mmimadi/dancelight/Marketing/photo_2020-08-12_01-08-17.jpg

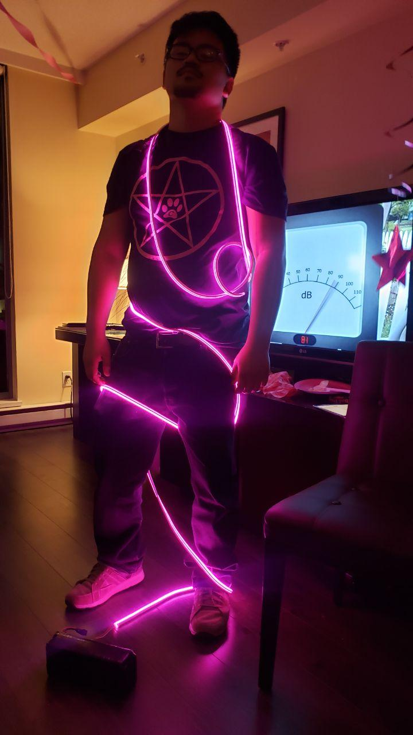
Marketing/photo_2020-08-12_01-08-17.jpg
