mmimadi/dancelight/Marketing/Depositphotos_21451605_s-2015.jpg

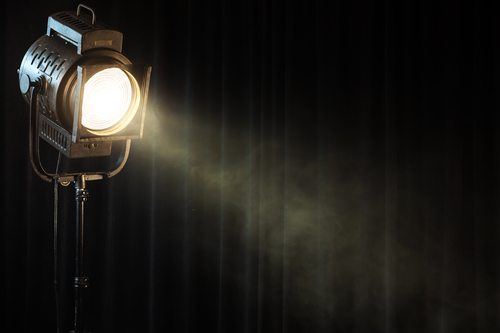
Marketing/Depositphotos_21451605_s-2015.jpg
