mmimadi/dancelight/Bom.xlsx

BOM
Rave Light Driver PCB Main Board | Yellow = No Assembly
Rev 1
Reference | Value/Part Number | Footprint | MPN | LCSC Part # | Notes | Datasheet | Source
C1, C2, C3 | 10uf | Capacitor_SMD:CP_Elec_4x5.3 | VE-100M1ETR-0405 | C134721 (https://lcsc.com/product-detail/Aluminum-Electrolytic-Capacitors-SMD_Lelon-VE-100M1ETR-0405_C134721.html/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) |  | ~
C4, C12 | 22uf | Capacitor_SMD:C_0603_1608Metric | CL21A226MAQNNNE | C45783 (https://lcsc.com/product-detail/Multilayer-Ceramic-Capacitors-MLCC-SMD-SMT_SAMSUNG_CL21A226MAQNNNE_22uF-226-20-25V_C45783.html/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) |  | ~
C5, C6 | 100uf | Capacitor_SMD:CP_Elec_6.3x7.7 | VES101M1ETR-0607 | C176675 (https://lcsc.com/product-detail/Aluminum-Electrolytic-Capacitors-SMD_Lelon-VES101M1ETR-0607_C176675.html/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) |  | ~
C8, C9 | 1uf | Capacitor_SMD:C_0603_1608Metric | CL10A105KB8NNNC | C15849 (https://lcsc.com/product-detail/Multilayer-Ceramic-Capacitors-MLCC-SMD-SMT_SAMSUNG_CL10A105KB8NNNC_1uF-105-10-50V_C15849.html/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) |  | ~
C10 | 10uf | Capacitor_SMD:C_0603_1608Metric | CL10A106KP8NNNC | C19702 (https://lcsc.com/product-detail/Multilayer-Ceramic-Capacitors-MLCC-SMD-SMT_SAMSUNG_CL10A106KP8NNNC_10uF-106-10-10V_C19702.html/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) |  | ~
C7, C11 | .1uf | Capacitor_SMD:C_0603_1608Metric | CC0603KRX7R9BB104 | C14663 (https://lcsc.com/product-detail/Multilayer-Ceramic-Capacitors-MLCC-SMD-SMT_100nF-104-10-50V_C14663.html/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) |  | ~
D1, D2, D3 | 1N5819 | Diode_SMD:D_SOD-323 | 1N5819WS | C191023 (https://lcsc.com/product-detail/Others_B5819WS_C191023.html/?href=jlc-SMT) |  | ~
FB1 | 2A Ferrite Bead | Resistor_SMD:R_0805_2012Metric | PZ2012U221-2R0TF | C44361 (https://lcsc.com/product-detail/Beads_Sunlord-PZ2012U221-2R0TF_C44361.html/?href=jlc-SMT) |  | ~
L1 | 10uh | Inductor_SMD:L_Sunlord_MWSA0518_5.4x5.2mm | MWSA0503-100MT | C139506 (https://lcsc.com/product-detail/Power-Inductors_Sunlord-MWSA0503-100MT_C139506.html/?href=jlc-SMT) |  | ~
L2 | 1uh | Inductor_SMD:L_0805_2012Metric | MLP2016S1R0MT0S1 | C76793 (https://lcsc.com/product-detail/Inductors-SMD_TDK_MLP2016S1R0MT0S1_TDK-MLP2016S1R0MT0S1_C76793.html/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) |  | ~
Q1, Q2 | MMBT3904-TP | Package_TO_SOT_SMD:SOT-23 | MMBT3904-TP | C77991 (https://lcsc.com/product-detail/Transistors_MCC_MMBT3904-TP_MMBT3904-TP_C77991.html/?href=jlc-SMT) |  | ~
Q3 | AO4484 | Main Board1:SOIC-8_3.9x4.9mm_P1.27mm | AO4484 |  |  | http://www.ti.com/lit/gpn/csd16342q5a
R1 | 6.8k | Resistor_SMD:R_0603_1608Metric | 0603WAF6801T5E | C23212 (https://lcsc.com/product-detail/Chip-Resistor-Surface-Mount_Uniroyal-Elec-0603WAF6801T5E_C23212.html/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) |  | ~
R2, R5 | 100k | Resistor_SMD:R_0603_1608Metric | 0603WAF1003T5E | C25803 (https://lcsc.com/product-detail/Chip-Resistor-Surface-Mount_Uniroyal-Elec-0603WAF1003T5E_C25803.html/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) |  | ~
R3, R6, R14, R18, R19 | 10k | Resistor_SMD:R_0603_1608Metric | 0603WAF1002T5E | C25804 (https://lcsc.com/product-detail/Chip-Resistor-Surface-Mount_Uniroyal-Elec-0603WAF1002T5E_C25804.html/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) |  | ~
R4, R7, R9 | 1k | Resistor_SMD:R_0603_1608Metric | 0603WAF1001T5E | C21190 (https://lcsc.com/product-detail/Chip-Resistor-Surface-Mount_Uniroyal-Elec-0603WAF1001T5E_C21190.html/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) |  | ~
R12 | 205k | Resistor_SMD:R_0603_1608Metric | 0603WAF2053T5E | C22949 (https://lcsc.com/product-detail/Chip-Resistor-Surface-Mount_Uniroyal-Elec-0603WAF2053T5E_C22949.html/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) |  | ~
R13 | 68k | Resistor_SMD:R_0603_1608Metric | 0603WAF6802T5E | C23231 (https://lcsc.com/product-detail/Chip-Resistor-Surface-Mount_Uniroyal-Elec-0603WAF6802T5E_C23231.html/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) |  | ~
R15 | 43k | Resistor_SMD:R_0603_1608Metric | 0603WAF4302T5E | C23172 (https://lcsc.com/product-detail/Chip-Resistor-Surface-Mount_Uniroyal-Elec-0603WAF4302T5E_C23172.html/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) |  | ~
R16 | 2.7k | Resistor_SMD:R_0603_1608Metric | 0603WAF2701T5E | C13167 (https://lcsc.com/product-detail/Chip-Resistor-Surface-Mount_Uniroyal-Elec-0603WAF2701T5E_C13167.html/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) |  | ~
R8, R17 | 1M | Resistor_SMD:R_0603_1608Metric | 0603WAF1004T5E | C22935 (https://lcsc.com/product-detail/Chip-Resistor-Surface-Mount_Uniroyal-Elec-0603WAF1004T5E_C22935.html/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) |  | ~
R20 | 220R | Resistor_SMD:R_0603_1608Metric | 0603WAF2200T5E | C22962 (https://lcsc.com/product-detail/Chip-Resistor-Surface-Mount_Uniroyal-Elec-0603WAF2200T5E_C22962.html/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) |  | ~
SW1 | Momentary | Main Board1:tactile | TS-1187A-C-E-B | C318887 (https://lcsc.com/product-detail/Tactile-Switches_XKB-Enterprise-TS-1187A-C-E-A_C318887.html/?href=jlc-SMT) |  | ~
TH1 | Thermistor | Capacitor_SMD:C_0805_2012Metric | NTCG163JF103FT1 | C76589 (https://lcsc.com/product-detail/NTC-Thermistors_TDK_NTCG163JF103FT1_NTC-Thermistor-10KR-1_C76589.html/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) |  | ~
U1 | MT3608 Boost Converter | SOT-23-6 | MT3608 | C84817 (https://lcsc.com/product-detail/DC-DC-Converters_MT3608_C84817.html/?href=jlc-SMT) |  | https://datasheet.lcsc.com/szlcsc/XI-AN-Aerosemi-Tech-MT3608_C84817.pdf
U2 | NCP718A Linear Reg | 6-WDFN | NCP718AMTADJTBG |  |  | https://www.onsemi.com/pub/Collateral/NCP718-D.PDF
U3 | ATTINY 1614 | SOIC-14 | ATTINY1614-SSFR | C141724 (https://lcsc.com/product-detail/ATMEL-AVR_Microchip-Tech_ATTINY1614-SSFR_Microchip-Tech-ATTINY1614-SSFR_C141724.html/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) |  | https://datasheet.lcsc.com/szlcsc/Microchip-Tech-ATTINY1614-SSFR_C141724.pdf
