mmimadi/dancelight/Expenses.xlsx

Item | Quantity | Price | From | Notes
Condensor Mic | 4 | $4.50 | digikey
10uf electroyltic caps | 5 | $2 | digikey
NPN BJT transistor | 10 | $5 | digikey
Lights, Fets, cables and chargers | lots! | $20 | ali express | I don’t remember lol
digikey prototype order | lots! | $50 | digikey | I don’t remember lol
Production test run LED order | for 12x units | $70 | ali express | split half
boost test boards | 2 units | $5.50 | amazon | I fucked these up. Just scrap this cost lol
Prouction Run | 30 units SMT | $172 | JLCPCB | already split half
DIGI parts for first run | lots! | $84
 | Sum: | $413.00
