mmimadi/dancelight/3D Models/Case/Rave Light Case.SLDPRT

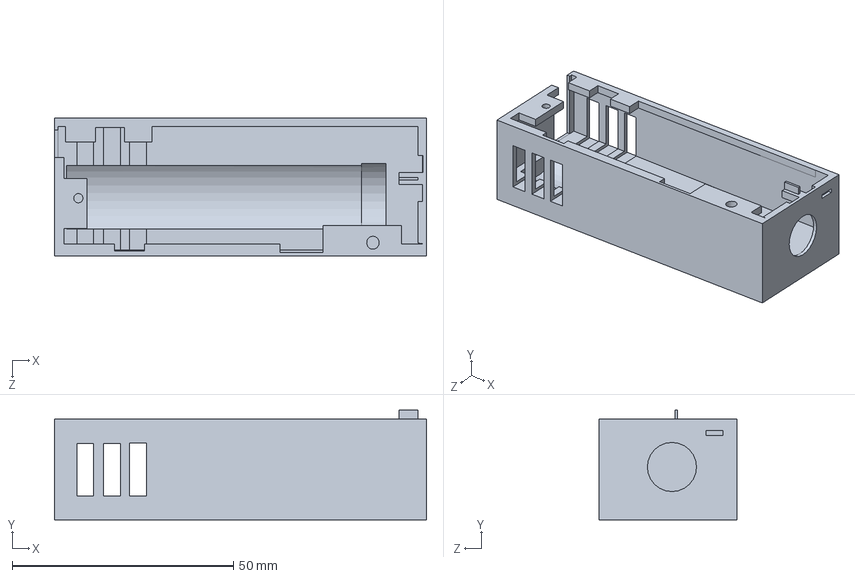
[picture p3: CAD file, 2020-08-26]
3D Models/Case/Rave Light Case.SLDPRT
84.0 x 24.8 x 31.1 mm
