mmimadi/dancelight/3D Models/MIC POM-2738P-R.STEP

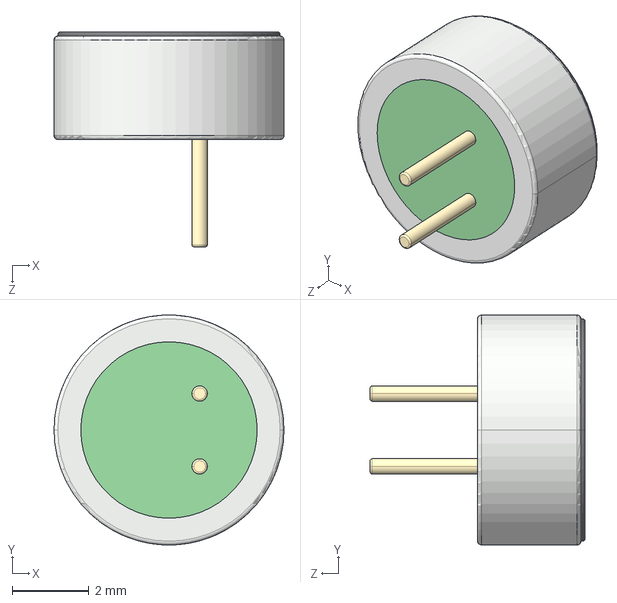
[picture p4: CAD file, 2020-06-27]
3D Models/MIC POM-2738P-R.STEP
6.00 x 6.00 x 5.60 mm
