mmimadi/dancelight/3D Models/Case/Rave Light Top.SLDPRT

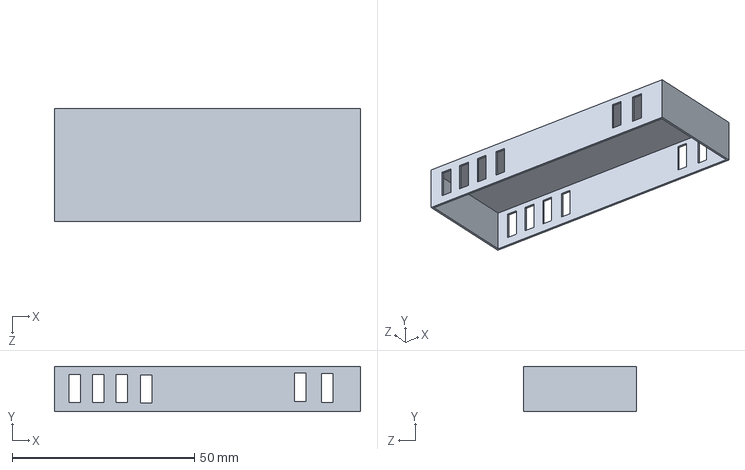
[picture p5: CAD file, 2020-08-26]
3D Models/Case/Rave Light Top.SLDPRT
84.0 x 12.4 x 31.1 mm
