mmimadi/dancelight/Hardware/Main Board/Main Board.kicad_pcb

## KiCad design Hardware/Main Board/Main Board.kicad_pcb (2020-08-12)

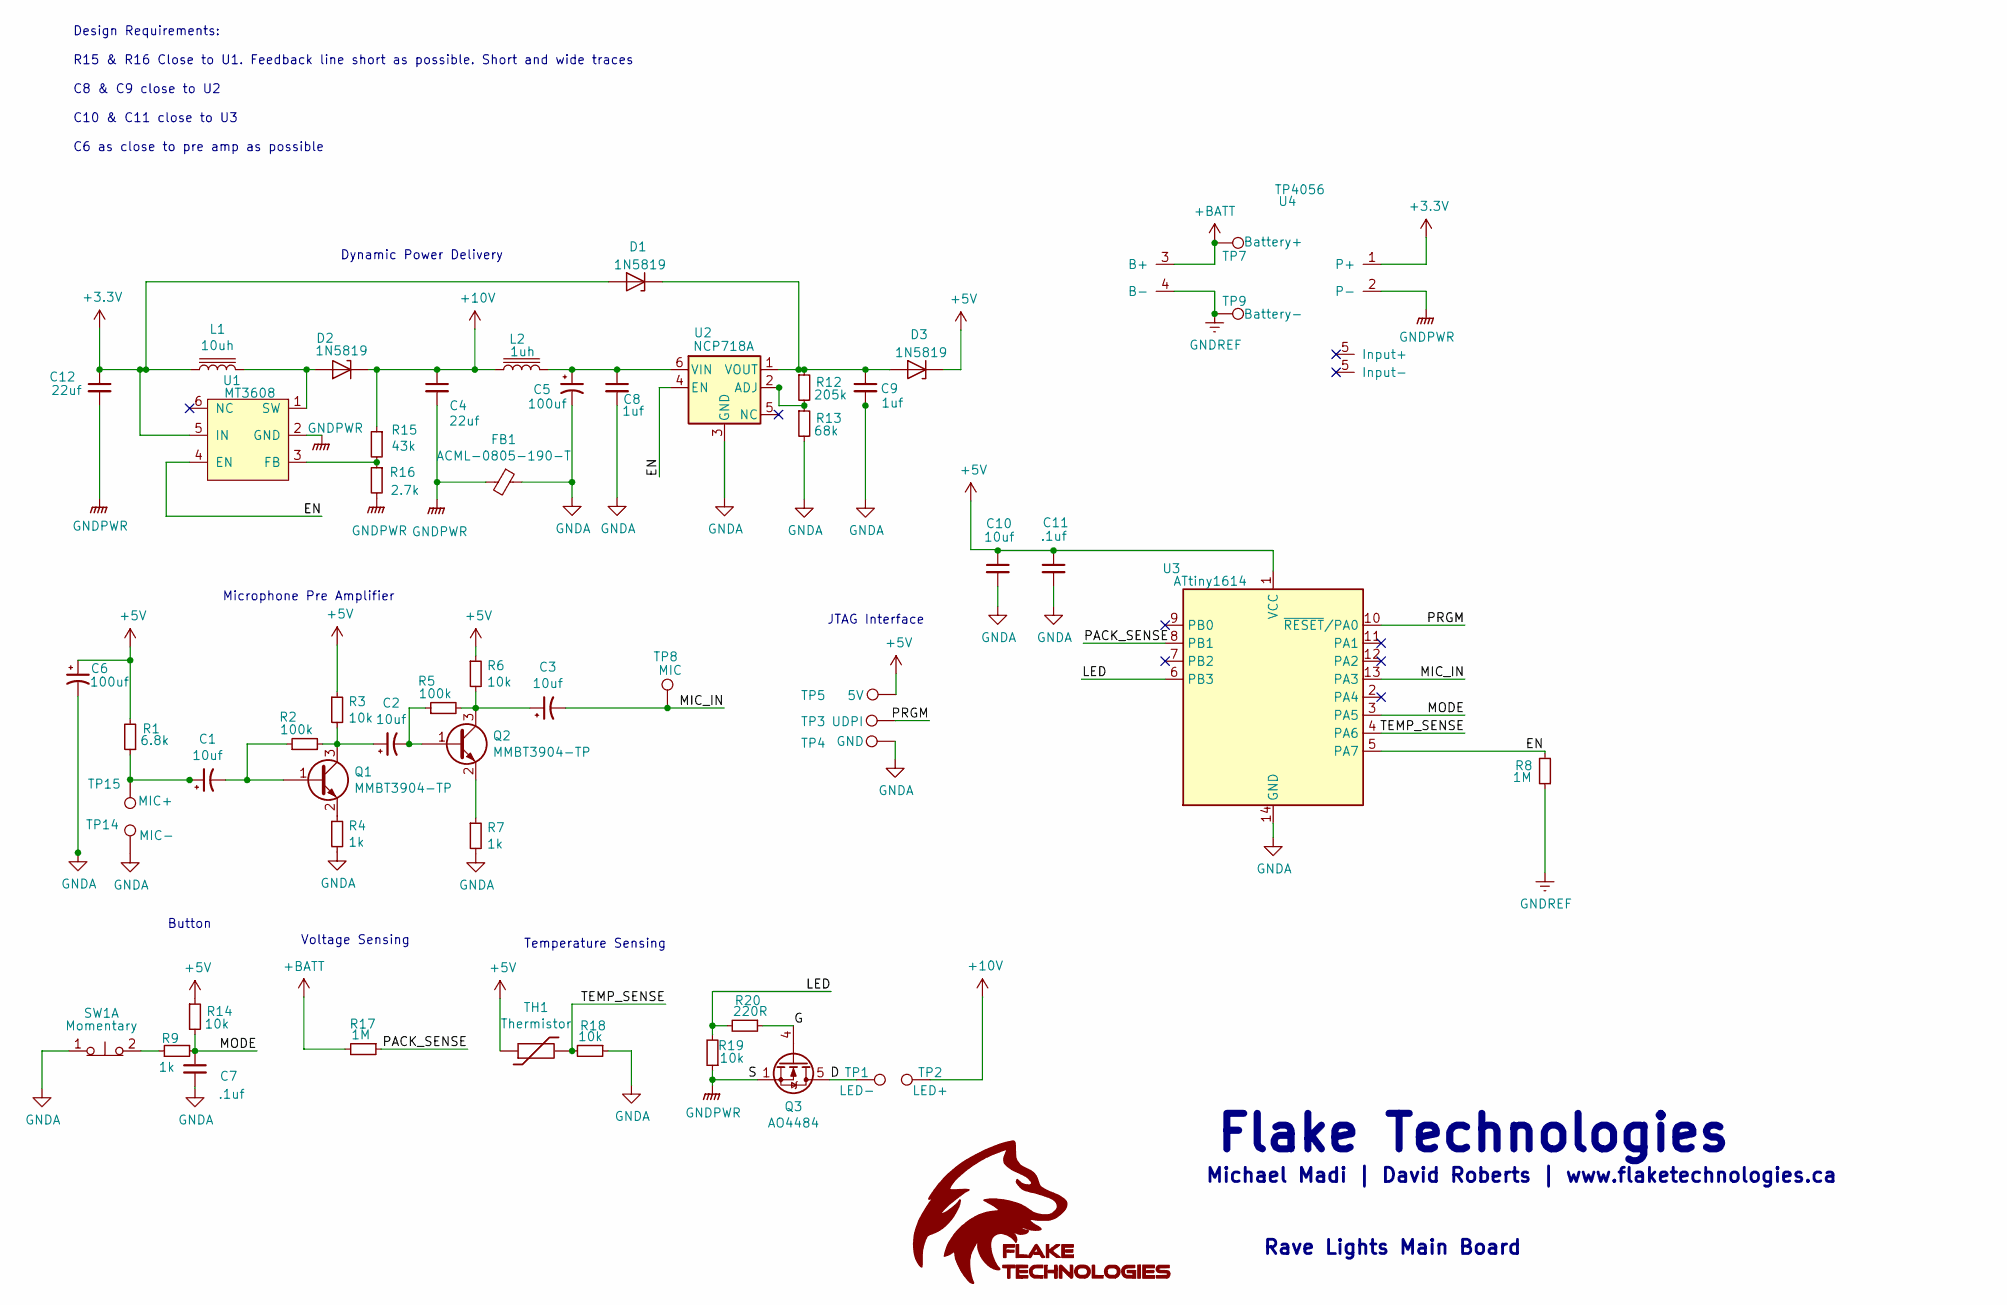
[picture p6: schematic Main Board.sch]

Parts:
C1, C2, C3: 10uf; CP_Elec_4x5.3
C4, C12: 22uf; C_0805_2012Metric
C5, C6: 100uf; CP_Elec_6.3x7.7
C7, C11: .1uf; C_0603_1608Metric
C8, C9: 1uf; C_0603_1608Metric
C10: 10uf; C_0603_1608Metric
D1, D2, D3: 1N5819; D_SOD-323
FB1: ACML-0805-190-T; R_0603_1608Metric
L1: 10uh; L_Sunlord_MWSA0518_5.4x5.2mm
L2: 1uh; L_0805_2012Metric
Q1, Q2: MMBT3904-TP; SOT-23
Q3: AO4484; SOIC-8_3.9x4.9mm_P1.27mm
R1: 6.8k; R_0603_1608Metric
R2, R5: 100k; R_0603_1608Metric
R3, R6, R14, R18, R19: 10k; R_0603_1608Metric
R4, R7, R9: 1k; R_0603_1608Metric
R8, R17: 1M; R_0603_1608Metric
R12: 205k; R_0603_1608Metric
R13: 68k; R_0603_1608Metric
R15: 43k; R_0603_1608Metric
R16: 2.7k; R_0603_1608Metric
R20: 220R; R_0603_1608Metric
SW1: Momentary; tactile
TH1: Thermistor; C_0805_2012Metric
TP1: LED-; TestPoint_Pad_3.0x3.0mm
TP2: LED+; TestPoint_Pad_3.0x3.0mm
TP3: UDPI; TestPoint_Pad_D2.5mm
TP4: GND; TestPoint_Pad_D2.5mm
TP5: 5V; TestPoint_Pad_D2.5mm
TP7: Battery+; TestPoint_Pad_3.0x3.0mm
TP8: MIC; TestPoint_Pad_D2.0mm
TP9: Battery-; TestPoint_Pad_3.0x3.0mm
TP14: MIC+; TestPoint_Keystone_5019_Minature
TP15: MIC-; TestPoint_Keystone_5019_Minature
U1: MT3608; SOT-23-6
U2: NCP718A; SON65P200X200X80-7N
U3: ATtiny1614; SOIC-14_3.9x8.7mm_P1.27mm
U4: TP4056; charger

Connections:
+3V3: C12.1, D1.2 (A), L1.2, U1.5 (IN), U4.1 (P+)
+5V: C6.1, C10.1, C11.1, D3.1 (K), R1.2, R3.1, R6.1, R14.1, TH1.1, TP5.1, U3.1 (VCC)
+10V: C4.1, D2.1 (K), L2.2, R15.1, TP2.1
+BATT: R17.2, TP7.1, U4.3 (B+)
/D: Q3.5 (D), TP1.1
/EN: R8.2, U1.4 (EN), U2.4 (EN), U3.5 (PA7)
/G: Q3.4 (G), R20.1
/LED: R19.2, R20.2, U3.6 (PB3)
/MIC_IN: C3.2, TP8.1, U3.13 (PA3)
/MODE: C7.1, R9.1, R14.2, U3.3 (PA5)
/PACK_SENSE: R17.1, U3.8 (PB1)
/PRGM: TP3.1, U3.10 (~RESET~/PA0)
/TEMP_SENSE: R18.2, TH1.2, U3.4 (PA6)
GNDA: C5.2, C6.2, C7.2, C8.2, C9.2, C10.2, C11.2, FB1.1, R4.2, R7.2, R13.2, R18.1, SW1.1, TP4.1, TP15.1, U2.3 (GND), U3.14 (GND)
GNDPWR: C4.2, C12.2, FB1.2, Q3.1 (S), Q3.2 (S), Q3.3 (S), R16.2, R19.1, U1.2 (GND), U4.2 (P-)
GNDREF: R8.1, TP9.1, U4.4 (B-)
unnamed: C1.1, R1.1, TP14.1
unnamed: C1.2, Q1.1 (B), R2.1
unnamed: C2.1, Q1.3 (C), R2.2, R3.2
unnamed: C2.2, Q2.1 (B), R5.1
unnamed: C3.1, Q2.3 (C), R5.2, R6.2
unnamed: C5.1, C8.1, L2.1, U2.6 (VIN)
unnamed: C9.1, D1.1 (K), D3.2 (A), R12.1, U2.1 (VOUT)
unnamed: D2.2 (A), L1.1, U1.1 (SW)
unnamed: Q1.2 (E), R4.1
unnamed: Q2.2 (E), R7.1
unnamed: R9.2, SW1.2
unnamed: R12.2, R13.1, U2.2 (ADJ)
unnamed: R15.2, R16.1, U1.3 (FB)

Notes on the sheet:
Microphone Pre Amplifier
Voltage Sensing
Temperature Sensing
Button
Michael Madi | David Roberts | www.flaketechnologies.ca
Rave Lights Main Board
JTAG Interface
Dynamic Power Delivery
Design Requirements: R15 & R16 Close to U1. Feedback line short as possible. Short and wide traces C8 & C9 close to U2 C10 & C11 close to U3 C6 as close to pre amp as possible
Flake Technologies

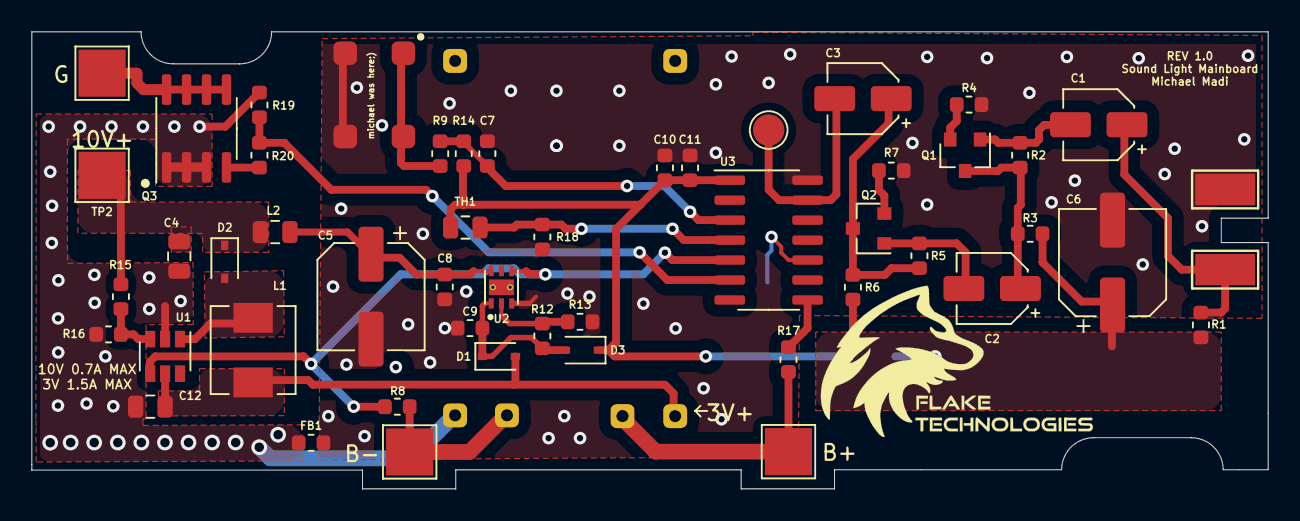
[picture p7: board Main Board.kicad_pcb from above]

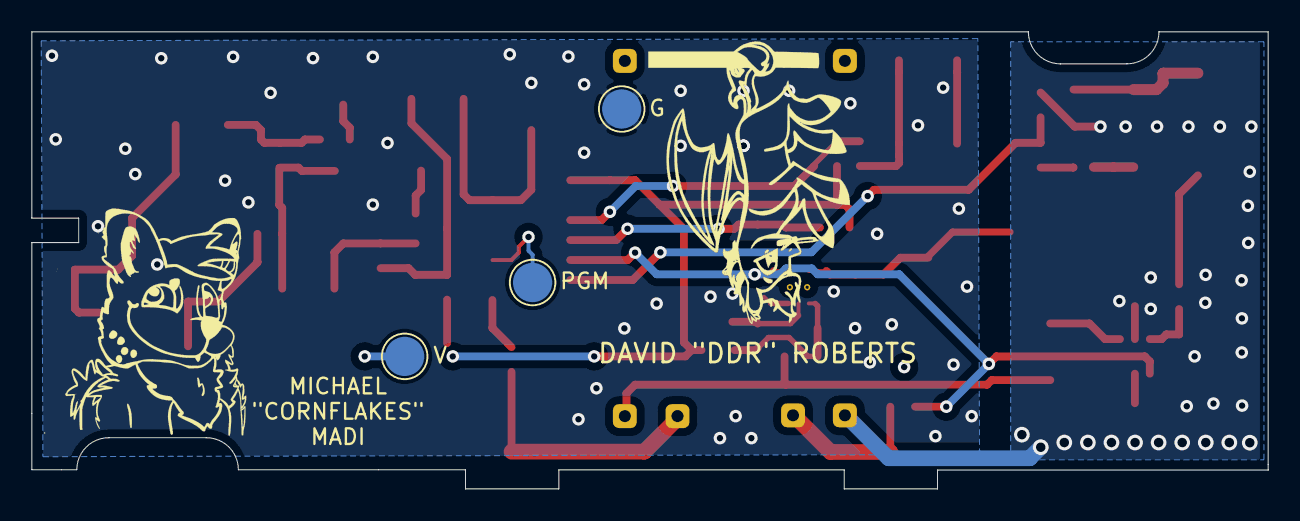
[picture p8: board Main Board.kicad_pcb from below]

Board: 2 copper layers, 78.7 x 29.1 mm, 55 parts (3 on the bottom side), 29 nets.
