mmimadi/dancelight/Firmware/Benchmark/Benchmark.ino

int mic = 0;
int val = 0;

void setup() {

  Serial.begin(115200);
  pinMode(mic, INPUT);
  pinMode(4, OUTPUT);
    pinMode(3, OUTPUT);

}

void loop() {
  
 // val = analogRead(mic);
 digitalWrite(3, HIGH);
 analogRead(mic);
 
 
// delay(1000);
// digitalWrite(3, LOW);
 // delay(1000);
  //digitalWrite(3, HIGH);
  Serial.println(analogRead(mic));
  
}
