mmimadi/dancelight/Firmware/combined/preset_pattern_state_machine.ino

/////////////////////////////
//   DDR's Blinking Code   //
/////////////////////////////

static const unsigned short int pattern_data[] PROGMEM = {
  START,  0, BLINK, 255, 10000,
  START,  0, BLINK, 255, 100, BLINK, 0, 50, REPEAT, 6, 4,
  START,  0, UBLINK, 255, 1000, UBLINK, 0, 10000, REPEAT, 6, 200,
  START,  0, BLINK, 255, 1000,
  //<<<<<<< Updated upstream

  //  //Decreasing Sweep, 1.4s
  START, 10, BLINK, 255, 16, BLINK, 252, 16, BLINK, 250, 16, BLINK, 247, 16, BLINK, 245, 16, BLINK, 242, 16, BLINK, 240, 16, BLINK, 237, 16, BLINK, 235, 16, BLINK, 232, 16, BLINK, 230, 16, BLINK, 227, 16, BLINK, 224, 16, BLINK, 222, 16, BLINK, 219, 16, BLINK, 217, 16, BLINK, 214, 16, BLINK, 212, 16, BLINK, 209, 16, BLINK, 207, 16, BLINK, 204, 16, BLINK, 201, 16, BLINK, 199, 16, BLINK, 196, 16, BLINK, 194, 16, BLINK, 191, 16, BLINK, 189, 16, BLINK, 186, 16, BLINK, 184, 16, BLINK, 181, 16, BLINK, 179, 16, BLINK, 176, 16, BLINK, 173, 16, BLINK, 171, 16, BLINK, 168, 16, BLINK, 166, 16, BLINK, 163, 16, BLINK, 161, 16, BLINK, 158, 16, BLINK, 156, 16, BLINK, 153, 16, BLINK, 150, 16, BLINK, 148, 16, BLINK, 145, 16, BLINK, 143, 16, BLINK, 140, 16, BLINK, 138, 16, BLINK, 135, 16, BLINK, 133, 16, BLINK, 130, 16, BLINK, 128, 16, BLINK, 125, 16, BLINK, 122, 16, BLINK, 120, 16, BLINK, 117, 16, BLINK, 115, 16, BLINK, 112, 16, BLINK, 110, 16, BLINK, 107, 16, BLINK, 105, 16, BLINK, 102, 16, BLINK, 99, 16, BLINK, 97, 16, BLINK, 94, 16, BLINK, 92, 16, BLINK, 89, 16, BLINK, 87, 16, BLINK, 84, 16, BLINK, 82, 16, BLINK, 79, 16, BLINK, 77, 16, BLINK, 74, 16, BLINK, 71, 16, BLINK, 69, 16, BLINK, 66, 16, BLINK, 64, 16, BLINK, 61, 16, BLINK, 59, 16, BLINK, 56, 16, BLINK, 54, 16, BLINK, 51, 16, BLINK, 48, 16, BLINK, 46, 16, BLINK, 43, 16, BLINK, 41, 16, BLINK, 38, 16, BLINK, 36, 16, BLINK, 33, 16, BLINK, 31, 16, BLINK, 28, 16, BLINK, 25, 16, BLINK, 23, 16, BLINK, 20, 16, BLINK, 18, 16, BLINK, 15, 16, BLINK, 13, 16, BLINK, 10, 16, BLINK, 8, 16, BLINK, 5, 16, BLINK, 3, 16, BLINK, 0, 16,
  //
  //  //Increasing Sweep, 1.4s
  START, 10, BLINK, 0, 16, BLINK, 3, 16, BLINK, 5, 16, BLINK, 8, 16, BLINK, 10, 16, BLINK, 13, 16, BLINK, 15, 16, BLINK, 18, 16, BLINK, 20, 16, BLINK, 23, 16, BLINK, 26, 16, BLINK, 28, 16, BLINK, 31, 16, BLINK, 33, 16, BLINK, 36, 16, BLINK, 38, 16, BLINK, 41, 16, BLINK, 43, 16, BLINK, 46, 16, BLINK, 48, 16, BLINK, 51, 16, BLINK, 54, 16, BLINK, 56, 16, BLINK, 59, 16, BLINK, 61, 16, BLINK, 64, 16, BLINK, 66, 16, BLINK, 69, 16, BLINK, 71, 16, BLINK, 74, 16, BLINK, 77, 16, BLINK, 79, 16, BLINK, 82, 16, BLINK, 84, 16, BLINK, 87, 16, BLINK, 89, 16, BLINK, 92, 16, BLINK, 94, 16, BLINK, 97, 16, BLINK, 99, 16, BLINK, 102, 16, BLINK, 105, 16, BLINK, 107, 16, BLINK, 110, 16, BLINK, 112, 16, BLINK, 115, 16, BLINK, 117, 16, BLINK, 120, 16, BLINK, 122, 16, BLINK, 125, 16, BLINK, 128, 16, BLINK, 130, 16, BLINK, 133, 16, BLINK, 135, 16, BLINK, 138, 16, BLINK, 140, 16, BLINK, 143, 16, BLINK, 145, 16, BLINK, 148, 16, BLINK, 150, 16, BLINK, 153, 16, BLINK, 156, 16, BLINK, 158, 16, BLINK, 161, 16, BLINK, 163, 16, BLINK, 166, 16, BLINK, 168, 16, BLINK, 171, 16, BLINK, 173, 16, BLINK, 176, 16, BLINK, 179, 16, BLINK, 181, 16, BLINK, 184, 16, BLINK, 186, 16, BLINK, 189, 16, BLINK, 191, 16, BLINK, 194, 16, BLINK, 196, 16, BLINK, 199, 16, BLINK, 201, 16, BLINK, 204, 16, BLINK, 207, 16, BLINK, 209, 16, BLINK, 212, 16, BLINK, 214, 16, BLINK, 217, 16, BLINK, 219, 16, BLINK, 222, 16, BLINK, 224, 16, BLINK, 227, 16, BLINK, 230, 16, BLINK, 232, 16, BLINK, 235, 16, BLINK, 237, 16, BLINK, 240, 16, BLINK, 242, 16, BLINK, 245, 16, BLINK, 247, 16, BLINK, 250, 16, BLINK, 252, 16, BLINK, 255, 16,


  //Decreasing Sweep, 1.4s
  START, 10, BLINK, 255, 16, BLINK, 252, 16, BLINK, 250, 16, BLINK, 247, 16, BLINK, 245, 16, BLINK, 242, 16, BLINK, 240, 16, BLINK, 237, 16, BLINK, 235, 16, BLINK, 232, 16, BLINK, 230, 16, BLINK, 227, 16, BLINK, 224, 16, BLINK, 222, 16, BLINK, 219, 16, BLINK, 217, 16, BLINK, 214, 16, BLINK, 212, 16, BLINK, 209, 16, BLINK, 207, 16, BLINK, 204, 16, BLINK, 201, 16, BLINK, 199, 16, BLINK, 196, 16, BLINK, 194, 16, BLINK, 191, 16, BLINK, 189, 16, BLINK, 186, 16, BLINK, 184, 16, BLINK, 181, 16, BLINK, 179, 16, BLINK, 176, 16, BLINK, 173, 16, BLINK, 171, 16, BLINK, 168, 16, BLINK, 166, 16, BLINK, 163, 16, BLINK, 161, 16, BLINK, 158, 16, BLINK, 156, 16, BLINK, 153, 16, BLINK, 150, 16, BLINK, 148, 16, BLINK, 145, 16, BLINK, 143, 16, BLINK, 140, 16, BLINK, 138, 16, BLINK, 135, 16, BLINK, 133, 16, BLINK, 130, 16, BLINK, 128, 16, BLINK, 125, 16, BLINK, 122, 16, BLINK, 120, 16, BLINK, 117, 16, BLINK, 115, 16, BLINK, 112, 16, BLINK, 110, 16, BLINK, 107, 16, BLINK, 105, 16, BLINK, 102, 16, BLINK, 99, 16, BLINK, 97, 16, BLINK, 94, 16, BLINK, 92, 16, BLINK, 89, 16, BLINK, 87, 16, BLINK, 84, 16, BLINK, 82, 16, BLINK, 79, 16, BLINK, 77, 16, BLINK, 74, 16, BLINK, 71, 16, BLINK, 69, 16, BLINK, 66, 16, BLINK, 64, 16, BLINK, 61, 16, BLINK, 59, 16, BLINK, 56, 16, BLINK, 54, 16, BLINK, 51, 16, BLINK, 48, 16, BLINK, 46, 16, BLINK, 43, 16, BLINK, 41, 16, BLINK, 38, 16, BLINK, 36, 16, BLINK, 33, 16, BLINK, 31, 16, BLINK, 28, 16, BLINK, 25, 16, BLINK, 23, 16, BLINK, 20, 16, BLINK, 18, 16, BLINK, 15, 16, BLINK, 13, 16, BLINK, 10, 16, BLINK, 8, 16, BLINK, 5, 16, BLINK, 3, 16, BLINK, 0, 16,

  //Increasing Sweep, 1.4s
  START, 10, BLINK, 0, 16, BLINK, 3, 16, BLINK, 5, 16, BLINK, 8, 16, BLINK, 10, 16, BLINK, 13, 16, BLINK, 15, 16, BLINK, 18, 16, BLINK, 20, 16, BLINK, 23, 16, BLINK, 26, 16, BLINK, 28, 16, BLINK, 31, 16, BLINK, 33, 16, BLINK, 36, 16, BLINK, 38, 16, BLINK, 41, 16, BLINK, 43, 16, BLINK, 46, 16, BLINK, 48, 16, BLINK, 51, 16, BLINK, 54, 16, BLINK, 56, 16, BLINK, 59, 16, BLINK, 61, 16, BLINK, 64, 16, BLINK, 66, 16, BLINK, 69, 16, BLINK, 71, 16, BLINK, 74, 16, BLINK, 77, 16, BLINK, 79, 16, BLINK, 82, 16, BLINK, 84, 16, BLINK, 87, 16, BLINK, 89, 16, BLINK, 92, 16, BLINK, 94, 16, BLINK, 97, 16, BLINK, 99, 16, BLINK, 102, 16, BLINK, 105, 16, BLINK, 107, 16, BLINK, 110, 16, BLINK, 112, 16, BLINK, 115, 16, BLINK, 117, 16, BLINK, 120, 16, BLINK, 122, 16, BLINK, 125, 16, BLINK, 128, 16, BLINK, 130, 16, BLINK, 133, 16, BLINK, 135, 16, BLINK, 138, 16, BLINK, 140, 16, BLINK, 143, 16, BLINK, 145, 16, BLINK, 148, 16, BLINK, 150, 16, BLINK, 153, 16, BLINK, 156, 16, BLINK, 158, 16, BLINK, 161, 16, BLINK, 163, 16, BLINK, 166, 16, BLINK, 168, 16, BLINK, 171, 16, BLINK, 173, 16, BLINK, 176, 16, BLINK, 179, 16, BLINK, 181, 16, BLINK, 184, 16, BLINK, 186, 16, BLINK, 189, 16, BLINK, 191, 16, BLINK, 194, 16, BLINK, 196, 16, BLINK, 199, 16, BLINK, 201, 16, BLINK, 204, 16, BLINK, 207, 16, BLINK, 209, 16, BLINK, 212, 16, BLINK, 214, 16, BLINK, 217, 16, BLINK, 219, 16, BLINK, 222, 16, BLINK, 224, 16, BLINK, 227, 16, BLINK, 230, 16, BLINK, 232, 16, BLINK, 235, 16, BLINK, 237, 16, BLINK, 240, 16, BLINK, 242, 16, BLINK, 245, 16, BLINK, 247, 16, BLINK, 250, 16, BLINK, 252, 16, BLINK, 255, 16,

  //Stashed changes
  //1-(sin(x/10*pi)^2) * (x%2) / 1.8 - modulated sawteeth of various formats, 5s
  //  START, 10, BLINK, 0, 16, BLINK, 0, 16, BLINK, 0, 16, BLINK, 0, 16, BLINK, 0, 16, BLINK, 0, 16, BLINK, 0, 16, BLINK, 0, 16, BLINK, 0, 16, BLINK, 0, 16, BLINK, 1, 16, BLINK, 1, 16, BLINK, 1, 16, BLINK, 1, 16, BLINK, 1, 16, BLINK, 2, 16, BLINK, 2, 16, BLINK, 3, 16, BLINK, 3, 16, BLINK, 4, 16, BLI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
  //
  //  //modulated blinkies, 5s
  START, 10, BLINK, 0, 16, BLINK, 0, 16, BLINK, 0, 16, BLINK, 0, 16, BLINK, 0, 16, BLINK, 0, 16, BLINK, 0, 16, BLINK, 0, 16, BLINK, 0, 16, BLINK, 0, 16, BLINK, 0, 16, BLINK, 0, 16, BLINK, 0, 16, BLINK, 0, 16, BLINK, 0, 16, BLINK, 0, 16, BLINK, 0, 16, BLINK, 0, 16, BLINK, 0, 16, BLINK, 0, 16, BLINK, 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
  //
  //  //gentle waves w/ flicker, 5s
  START, 10, BLINK, 128, 16, BLINK, 128, 16, BLINK, 128, 16, BLINK, 128, 16, BLINK, 128, 16, BLINK, 128, 16, BLINK, 128, 16, BLINK, 128, 16, BLINK, 128, 16, BLINK, 128, 16, BLINK, 128, 16, BLINK, 128, 16, BLINK, 128, 16, BLINK, 128, 16, BLINK, 128, 16, BLINK, 128, 16, BLINK, 128, 16, BLINK, 128, 16,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
  //
  //  //chopped waves, 1.5s
  START, 20, BLINK, 0, 16, BLINK, 0, 16, BLINK, 0, 16, BLINK, 0, 16, BLINK, 0, 16, BLINK, 0, 16, BLINK, 12, 16, BLINK, 16, 16, BLINK, 21, 16, BLINK, 27, 16, BLINK, 34, 16, BLINK, 42, 16, BLINK, 51, 16, BLINK, 0, 16, BLINK, 0, 16, BLINK, 0, 16, BLINK, 100, 16, BLINK, 116, 16, BLINK, 135, 16, BLINK, 156, 16, BLINK, 180, 16, BLINK, 207, 16, BLINK, 238, 16, BLINK, 255, 16, BLINK, 0, 16, BLINK, 0, 16, BLINK, 0, 16, BLINK, 0, 16, BLINK, 255, 16, BLINK, 255, 16, BLINK, 255, 16, BLINK, 255, 16, BLINK, 255, 16, BLINK, 255, 16, BLINK, 255, 16, BLINK, 255, 16, BLINK, 0, 16, BLINK, 0, 16, BLINK, 0, 16, BLINK, 0, 16, BLINK, 255, 16, BLINK, 255, 16, BLINK, 255, 16, BLINK, 255, 16, BLINK, 255, 16, BLINK, 255, 16, BLINK, 255, 16, BLINK, 0, 16, BLINK, 0, 16, BLINK, 0, 16, BLINK, 255, 16, BLINK, 255, 16, BLINK, 255, 16, BLINK, 255, 16, BLINK, 255, 16, BLINK, 255, 16, BLINK, 255, 16, BLINK, 0, 16, BLINK, 0, 16, BLINK, 0, 16, BLINK, 0, 16, BLINK, 0, 16, BLINK, 255, 16, BLINK, 255, 16, BLINK, 255, 16, BLINK, 255, 16, BLINK, 255, 16, BLINK, 255, 16, BLINK, 238, 16, BLINK, 207, 16, BLINK, 0, 16, BLINK, 0, 16, BLINK, 0, 16, BLINK, 0, 16, BLINK, 100, 16, BLINK, 85, 16, BLINK, 72, 16, BLINK, 61, 16, BLINK, 51, 16, BLINK, 42, 16, BLINK, 0, 16, BLINK, 0, 16, BLINK, 0, 16, BLINK, 0, 16, BLINK, 12, 16, BLINK, 8, 16, BLINK, 5, 16, BLINK, 3, 16, BLINK, 1, 16, BLINK, 0, 16, BLINK, 0, 16,
  //
  //  //swoops, 0.75s
  START, 40, BLINK, 0, 16, BLINK, 1, 16, BLINK, 5, 16, BLINK, 12, 16, BLINK, 21, 16, BLINK, 34, 16, BLINK, 51, 16, BLINK, 72, 16, BLINK, 100, 16, BLINK, 135, 16, BLINK, 180, 16, BLINK, 238, 16, BLINK, 255, 16, BLINK, 255, 16, BLINK, 255, 16, BLINK, 255, 16, BLINK, 255, 16, BLINK, 255, 16, BLINK, 255, 16, BLINK, 255, 16, BLINK, 255, 16, BLINK, 255, 16, BLINK, 255, 16, BLINK, 255, 16, BLINK, 255, 16, BLINK, 255, 16, BLINK, 255, 16, BLINK, 255, 16, BLINK, 255, 16, BLINK, 255, 16, BLINK, 255, 16, BLINK, 255, 16, BLINK, 255, 16, BLINK, 255, 16, BLINK, 238, 16, BLINK, 180, 16, BLINK, 135, 16, BLINK, 100, 16, BLINK, 72, 16, BLINK, 51, 16, BLINK, 34, 16, BLINK, 21, 16, BLINK, 12, 16, BLINK, 5, 16, BLINK, 1, 16, BLINK, 0, 16,
  //
  //  //inverse swoops, 0.5s
  START, 50, BLINK, 0, 16, BLINK, 0, 16, BLINK, 1, 16, BLINK, 3, 16, BLINK, 5, 16, BLINK, 9, 16, BLINK, 13, 16, BLINK, 21, 16, BLINK, 31, 16, BLINK, 48, 16, BLINK, 76, 16, BLINK, 129, 16, BLINK, 242, 16, BLINK, 255, 16, BLINK, 255, 16, BLINK, 255, 16, BLINK, 255, 16, BLINK, 255, 16, BLINK, 242, 16, BLINK, 129, 16, BLINK, 77, 16, BLINK, 48, 16, BLINK, 31, 16, BLINK, 21, 16, BLINK, 13, 16, BLINK, 9, 16, BLINK, 5, 16, BLINK, 3, 16, BLINK, 1, 16, BLINK, 0, 16, BLINK, 0, 16,

  END,
};
unsigned short int patterns(unsigned short int i) {
  return pgm_read_word(&pattern_data[i]);
}

unsigned int pc; //Preset Counter
unsigned int pRepeat; //Repeat Counter


void resetPreset() {
  //Serial.println("reset presets");
  pc = 0;
  pRepeat = 0;
}

void selectRandomPreset() {
  short int increment = random(0, 200);
  LOG_SEEK && Serial.print("s: seeking preset +");
  LOG_SEEK && Serial.println(increment);
  while (increment > 0) {
    switch (patterns(pc)) {
      case END:
        resetPreset();
        continue;
      case START:
        LOG_SEEK && Serial.println("s: new pattern");
        increment -= patterns(pc + 1);
        pc += 2;
        continue;
      case BLINK:
      case UBLINK:
        LOG_SEEK && Serial.println("s: blink");
        pc += 3;
        continue;
      case REPEAT:
        LOG_SEEK && Serial.println("s: repeat");
        pc += 3; //skip delay value
        continue;
      default: //Unknown command, we probably mucked up the number of args to a command or something.
        Serial.print("s: invalid command ");
        Serial.print(patterns(pc));
        Serial.print("@");
        Serial.println(pc);
        delay(100); //flush the buffer
        exit(5); //Invalid command. Ruh roh.
    }
  }
}

void processPreset() {
  LOG_EXEC && Serial.print("p: command ");
  LOG_EXEC && Serial.print(patterns(pc));
  LOG_EXEC && Serial.print("@");
  LOG_EXEC && Serial.println(pc);
  switch (patterns(pc)) {
    return; case END:
      resetPreset();
    return; case START: //Seek random preset when we enholdCounter the start of one.
      selectRandomPreset();
    return; case BLINK:
      LOG_EXEC && Serial.println("p: blink ledPin");
      pc++; //consume instruction
      analogWrite(ledPin, patterns(pc++));
      delay(patterns(pc++));
    return; case UBLINK:
      LOG_EXEC && Serial.println("p: ublink ledPin");
      pc++; //consume instruction
      analogWrite(ledPin, patterns(pc++));
      delayMicroseconds(patterns(pc++));
    return; case REPEAT:
      LOG_EXEC && Serial.print("p: loop ");
      LOG_EXEC && Serial.println(pRepeat);
      switch (pRepeat) {
        break; case 0: //First loop.
          pRepeat = patterns(pc + 2) + 1;
          pc -= patterns(pc + 1);
        break; case 1: //Last loop. Skip the repeat this time.
          pRepeat--;
          pc += 3;
        break; default:
          pRepeat--;
          pc -= patterns(pc + 1);
      }
    return; default:
      Serial.print("p: invalid command ");
      Serial.print(patterns(pc));
      Serial.print("@");
      Serial.println(pc);
      delay(100);
      exit(5); //Invalid command. Ruh roh.
  }
}
