mmimadi/dancelight/Firmware/combined/ring_buffer_detection_mode.ino

float sampleCounter = 0;
float micRawValue = 0;
float processedResult = 0;

const int MODE_INSTANT = 0;
const int MODE_FADE = 1;
const int MODE = MODE_FADE;

unsigned long next_blink = 0;
unsigned long next_beat = 0;
unsigned int loop_iterations = 0;
unsigned int rbdm_silence_threshold = 44; //I changed this to from 15. //15 at ~300. TODO: determine if this scales with battery level.
unsigned int rbdm_min_beat_delay_ms = 100; //10 bps, or detect at most 600bpm.


unsigned int howBumpingIsIt = 0;
const unsigned int ITS_TOTALLY_LIT = MODE == MODE_INSTANT ? 2 : 27;

#define SAMPLE_LENGTH 100
unsigned int samples[SAMPLE_LENGTH] = {0};
unsigned int last_sample_index = SAMPLE_LENGTH - 1; //We just filled the array with 0s, so point to the last zero. (Makes initial sample code start from 0 instead of 1, not that it matters.)

//Add a sample to the buffer.
void addSample(unsigned int sample) {
  last_sample_index = ++last_sample_index % SAMPLE_LENGTH;
  samples[last_sample_index] = sample;
}

//Get the average sample.
unsigned int averageSample() {
  unsigned int accum = 0;
  for (int i = 0; i < SAMPLE_LENGTH; i++) accum += samples[i];
  return accum / SAMPLE_LENGTH;
}

int sampleSortCriteria(const void* a, const void* b) {
  return *(unsigned int*)a - *(unsigned int*)b;
}

//Get the top/bottom nth percentile values.
void findBoundingPercentiles(
  unsigned int& min,
  unsigned int& lower,
  unsigned int& middle,
  unsigned int& upper,
  unsigned int& max
) {
  const unsigned int PERCENTILE_INVERSE = 20; //3 = 33%, 5 = 20%, 10 = 10%, etc.
  static unsigned int sortedSamples[SAMPLE_LENGTH] = {0};
  memcpy(sortedSamples, samples, SAMPLE_LENGTH * sizeof(samples[0]));
  qsort(sortedSamples, SAMPLE_LENGTH, sizeof(samples[0]), sampleSortCriteria);

  min = sortedSamples[0];
  lower = sortedSamples[SAMPLE_LENGTH / PERCENTILE_INVERSE];
  middle = sortedSamples[SAMPLE_LENGTH / 2];
  upper = sortedSamples[SAMPLE_LENGTH - SAMPLE_LENGTH / PERCENTILE_INVERSE];
  max = sortedSamples[SAMPLE_LENGTH - 1];
}


void ringBufferLoop() {
  const float threshold = 0.9; //0..1 of max value in buffer
  auto sample = analogRead(micInputPin); //0..16000-ish, I think?

  unsigned int min, lower, middle, upper, max;
  findBoundingPercentiles(min, lower, middle, upper, max);

  /*if(loop_iterations % 100 == 0) {
    Serial.print("max "); Serial.print(max); Serial.print(", ");
    Serial.print("min "); Serial.print(min); Serial.print(", ");
    Serial.print("lower "); Serial.print(lower); Serial.print(", ");
    Serial.print("upper "); Serial.print(upper); Serial.print(", ");
    Serial.print("middle "); Serial.print(middle); Serial.print(", ");
    Serial.print("sample "); Serial.print(sample); Serial.println("");
    }
  */
  auto average = averageSample();

  if ((sample > upper || sample < lower) && upper - lower > rbdm_silence_threshold && millis() > next_beat) {
    howBumpingIsIt = ITS_TOTALLY_LIT; // ヽ( •_)ᕗ
    //Serial.print("beat 120");
    next_beat = millis() + rbdm_min_beat_delay_ms;
  } else {
    //Serial.println("beat 80");
  }
  if (howBumpingIsIt) SoundFadeDelayless();

  if (!(loop_iterations % 2)) addSample(sample);
  //addSample(sample);
  loop_iterations++;
}

void writeAndDelay(unsigned int brightness, unsigned int ms) {
  analogWrite(ledPin, brightness * 190 / 255);
  next_blink = millis() + ms;
}

void SoundFadeDelayless() {
  if (millis() >= next_blink) {
    if (MODE == MODE_INSTANT) {
      switch (howBumpingIsIt) {
        case  2: writeAndDelay(255, 16); break;
        case  1: writeAndDelay(  5, 16); break;
      }
    } else {
      switch (howBumpingIsIt) {
        case 27: writeAndDelay(255, 2); break;
        case 26: writeAndDelay(250, 2); break;
        case 25: writeAndDelay(240, 2); break;
        case 24: writeAndDelay(230, 2); break;
        case 23: writeAndDelay(220, 2); break;
        case 22: writeAndDelay(210, 3); break;
        case 21: writeAndDelay(200, 3); break;
        case 20: writeAndDelay(190, 3); break;
        case 19: writeAndDelay(180, 3); break;
        case 18: writeAndDelay(170, 2); break;
        case 17: writeAndDelay(160, 3); break;
        case 16: writeAndDelay(150, 4); break;
        case 15: writeAndDelay(140, 5); break;
        case 14: writeAndDelay(130, 5); break;
        case 13: writeAndDelay(120, 6); break;
        case 12: writeAndDelay(110, 5); break;
        case 11: writeAndDelay(100, 5); break;
        case 10: writeAndDelay( 90, 5); break;
        case  9: writeAndDelay( 80, 5); break;
        case  8: writeAndDelay( 70, 3); break;
        case  7: writeAndDelay( 60, 3); break;
        case  6: writeAndDelay( 50, 3); break;
        case  5: writeAndDelay( 40, 3); break;
        case  4: writeAndDelay( 30, 3); break;
        case  3: writeAndDelay( 20, 3); break;
        case  2: writeAndDelay( 10, 3); break;
        case  1: writeAndDelay(  5, 1); break;
      }
    }
    howBumpingIsIt--;
  }
}
