mmimadi/dancelight/(commit log)

2020-05-01 updated expenses
    [Expenses.xlsx]
2020-05-02 sexy revision for sound reaction
    [Expenses.xlsx]
2020-05-12 shcmeatic tuning
    [Main Board.sch]
2020-05-13 Added fade effect to sound_reaction.ino; broke beat detection. 😒😷
    [sound_reaction_fade.ino]
2020-05-13 stuff and things and fixes for sound_reaction_fade
    [sound_reaction_fade.ino]
2020-05-13 to do
    [Expenses.xlsx]
2020-05-14 failed boost converter
    [Main Board.sch]
2020-05-15 Added an untested version of floating beat detection.
    (For 100 samples, beat if sample - min > (max - min) * 0.9.)
2020-05-15 Fixed qsort comparison function.
    [sound_reaction_fade.ino]
2020-05-15 added boost converter, button and ton of work to schematic
    [Main Board.sch]
2020-05-16 schematic done. just calculate values now
    [Main Board.sch]
2020-05-20 calculated values for schematic
    [Main Board.sch]
2020-05-20 Voltage read code, expenses and voltage divider for linear reg update
    [Expenses.xlsx, Main Board.sch]
2020-05-25 fixed calculations and updated expense
    [Expenses.xlsx, Main Board.sch]
2020-05-28 work on boost
    [Main Board.sch]
2020-05-29 Fixed sound_reaction_fade statistics function.
    [sound_reaction_fade.ino]
2020-06-01 added feature list
    [Expenses.xlsx]
2020-06-02 feature list and hardware to do
    [Expenses.xlsx]
2020-06-05 Updated DC-DC design, updated MCU and added datasheets
    [Main Board.sch]
2020-06-15 Huge changes to schematic!
    [Main Board.sch]
2020-06-15 Added JTAG programming interface and decoupling cap on amp supply
    [Main Board.sch]
2020-06-16 started core functions code
    [Main Board.sch]
2020-06-17 Made ring buffer work better with cutofs and stuff. ❤
2020-06-17 Completed button handling code with inturupts
2020-06-17 Completed button handling code with inturupts and replaced pre_amp_test with Benchmark 😍😍😍
    [Benchmark.ino]
2020-06-18 EEPROM + New button added to combined ✌✌
2020-06-19 combined.ino: Merged in sound_reaction_fade.ino.
    - Split combined.ino into files, corresponding
    to functionality. They're still all global,
    mind you, but details. It might be time to
    get classes involved here.
    - I don't have the button hardware here, so I
    haven't really tested that code works.
2020-06-19 Fixed char -> string mistake.
    [combined.ino]
2020-06-19 minor adjustments
    [Main Board.sch]
2020-06-23 started low power mode but wont turn on again after being turned off 😢😢
2020-06-23 improved boot and shut down animations, fixed eeprom bug, check battery by double tapping even if off, psu fault checking for production, added tap to wake and now defaults to ON while we work on stu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
    [combined.ino, power_sequences.ino]
2020-06-25 fixed modes and improved animations and other tiny improvments
    [combined.ino, preset_pattern_state_machine.ino]
2020-06-26 voltage checking is now active with a double press! Can now boot device even if wake up light is active
2020-06-26 Switched to C++ from Arduino Sketch, for the most part.
    - This means, mostly, that we have I think per-file namespaces now?
2020-06-27 Removed old time-based button code as new cycle-based code works fine. :)
2020-06-27 Moved power sequence stuff into own class.
    - Pulled all pins into common.hpp, so they're together.
2020-06-27 added footprints to schematic. Some still need to be made but mostly all are done
    [MIC POM-2738P-R.STEP, Main Board.kicad_pcb, Main Board.sch]
2020-06-28 added a few more footprints before I got drunk and forgot to push lol
    [Main Board.sch]
2020-07-01 Tried to add Goertzel detection routine, but getting nonsensical error.
    - goertzel_detection_mode.cpp:11:28: error: no matching function
    for call to 'Goertzel::Goertzel()'
    - This doesn't make any sense, because this is never called
    in this manner. It's always got three floats in it.
    [combined.ino]
2020-07-01 Added base code for take 3 of beat detection. We got thisgit add .!
    [Main Board.kicad_pcb]
2020-07-02 Fixed up bandpass filter mode from beat detection v3 so that it doesn't monopolize the main loop.
    [bandpass_filter_beat.cpp, bandpass_filter_beat.hpp]
2020-07-03 placed PCB
    [Main Board.kicad_pcb, Main Board.sch]
2020-07-07 coper fills on PCB
    [Main Board.kicad_pcb, Main Board.sch]
2020-07-07 almost done pcb
    [Main Board.kicad_pcb]
2020-07-10 PCB completed and ready for reviewgit add .git add .
    [Main Board.kicad_pcb]
2020-07-17 PCB fixeruppers
    [Main Board.kicad_pcb, Main Board.sch]
2020-07-26 added marketing folder. we should maybe make a G drive soon if we start filling up.
    [BOM_PCB.xlsx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]
2020-07-29 board review done, almost done BOM and component map.
    [BOM_PCB.xlsx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]
2020-07-29 Broke out max duty cycle variable and exposed volume to bandpass filter beat mode.
    [bandpass_filter_beat.cpp, bandpass_filter_beat.hpp, combined.ino, common.hpp]
2020-07-30 board sent for production
    [BOM_PCB.xlsx, Bom.xlsx, Expenses.xlsx, Main Board.kicad_pcb, Main Board.sch, Map.csv]
2020-08-04 expenses update
    [Expenses.xlsx]
2020-08-12 added compatibility for the main board. button a little fucked tho
    [Main Board.kicad_pcb]
2020-08-19 commented where the ADC settings need to be updated
2020-08-26 Made solid mode max brightness - 55 to save on power.
2020-08-26 Removed failed ring buffer and goertzel detection modes.
    [combined.ino]
2020-08-26 Corrected issue wrt blink pattern only using presets #4 and #5.
    [preset_pattern_formulaic.cpp]
2020-08-26 tried to fix the registers
    [Rave Light Case.SLDPRT, Rave Light Top.SLDPRT]
2020-08-26 Added a #DEFINE in common.hpp so we can switch between dev and prod boards.
2020-08-26 Partially revert c87fec4d88ab7429b1dd00c26c663de7dc687d3d.
    - For some reason, all bytes in power_sequences.cpp were null.
    [power_sequences.cpp]
2020-08-26 Added Arduino Nano chip datasheet.
2020-08-27 interem fixed to bandpass filter beat
    [bandpass_filter_beat.cpp, common.hpp]
2020-08-30 Improvements to beat detection; elimination of double-bounce issue.
    [bandpass_filter_beat.cpp]
2020-08-30 Added rough estimate for bias for prod boards.
2020-08-31 Reverted power_sequences back to an .ino, so no cpp/hpp object bs.
    [combined.ino, power_sequences.ino]
